davy320/Embedded_robot/Core/Src/main.c

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
/* Includes ------------------------------------------------------------------*/
#include "main.h"

/* USER CODE BEGIN Includes */

#include "driver.h"
#include "motor_controller.h"
#include "accel.h"
#include "bluetooth.h"
#include "lidar.h"

/* USER CODE END Includes */

I2C_HandleTypeDef hi2c1;

SPI_HandleTypeDef hspi1;

TIM_HandleTypeDef htim3;

UART_HandleTypeDef huart1;

void SystemClock_Config(void);
static void MX_GPIO_Init(void);
static void MX_I2C1_Init(void);
static void MX_SPI1_Init(void);
static void MX_USART1_UART_Init(void);
static void MX_TIM3_Init(void);
/**
  * @brief  The application entry point.
  * @retval int
  */
int main(void)
{
  /* MCU Configuration--------------------------------------------------------*/

  /* Reset of all peripherals, Initializes the Flash interface and the Systick. */
  HAL_Init();

  /* Configure the system clock */
  SystemClock_Config();

  /* Initialize all configured peripherals */
  MX_GPIO_Init();
  MX_I2C1_Init();
  MX_SPI1_Init();
  MX_USART1_UART_Init();
  MX_TIM3_Init();
  /* USER CODE BEGIN 2 */


  initMotor(); /* Initiate DC motors to IDLE or stopped */
  Bluetooth_Init();

  /* USER CODE END 2 */

  /* Infinite loop */
  /* USER CODE BEGIN WHILE */


  uint8_t data;
  HAL_StatusTypeDef status;
  while (1)
  {

	  HAL_GPIO_TogglePin(GPIOE, GPIO_PIN_1);
      status = HAL_UART_Receive(&huart2, &data, 1, HAL_MAX_DELAY1);

	 if (status == HAL_OK) {
		// Data received successfully, toggle the LED
		HAL_GPIO_WritePin(GPIOB, GPIO_PIN_14, GPIO_PIN_RESET);  // Turn on the LED
		HAL_GPIO_WritePin(GPIOB, GPIO_PIN_0, GPIO_PIN_SET);  // Replace LD2_PIN with the pin connected to your LED
		HAL_Delay(1000);
	 } else {
		// Error in data reception, turn on the LED
		HAL_GPIO_WritePin(GPIOB, GPIO_PIN_0, GPIO_PIN_RESET);  // Replace LD2_PIN with the pin connected to your LED
		HAL_GPIO_WritePin(GPIOB, GPIO_PIN_14, GPIO_PIN_SET);  // Turn on the LED
	 }

    /* USER CODE END WHILE */

    /* USER CODE BEGIN 3 */

  }
  /* USER CODE END 3 */
}

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
