davy320/Embedded_robot/Core/Inc/main.h

#define MCO_Pin GPIO_PIN_0
#define MCO_GPIO_Port GPIOF
#define EN_A_Pin GPIO_PIN_0
#define EN_A_GPIO_Port GPIOA
#define INPUT_A_1_Pin GPIO_PIN_1
#define INPUT_A_1_GPIO_Port GPIOA
#define CS_XL_Pin GPIO_PIN_2
#define CS_XL_GPIO_Port GPIOA
#define INPUT_A_2_Pin GPIO_PIN_3
#define INPUT_A_2_GPIO_Port GPIOA
#define INPUT_B_1_Pin GPIO_PIN_4
#define INPUT_B_1_GPIO_Port GPIOA
#define INPUT_B_2_Pin GPIO_PIN_5
#define INPUT_B_2_GPIO_Port GPIOA
#define CS_MAG_Pin GPIO_PIN_7
#define CS_MAG_GPIO_Port GPIOA
#define XSHUT_Pin GPIO_PIN_0
#define XSHUT_GPIO_Port GPIOB
#define INT_MAG_Pin GPIO_PIN_12
#define INT_MAG_GPIO_Port GPIOA
#define SWDIO_Pin GPIO_PIN_13
#define SWDIO_GPIO_Port GPIOA
#define SWCLK_Pin GPIO_PIN_14
#define SWCLK_GPIO_Port GPIOA
#define VCP_RX_Pin GPIO_PIN_15
#define VCP_RX_GPIO_Port GPIOA
#define SDA_Pin GPIO_PIN_5
#define SDA_GPIO_Port GPIOB
