davy320/Embedded_robot/(commit log)

2023-09-08 Added drivers and other files
2023-09-08 configured motorB for PWM control
2023-09-08 Also add build files just in case #PWM config for motor2 EN_B complete
2023-09-17 Fixd bluetooth code to receive data and change name
    [bluetooth.c, bluetooth.h, main.c]
2023-11-01 Added Kicad design files as can't sent email on Outlook
